samos2807/riscv-pipeline/layout/README.md

# Final layout (round 5b, 1008 MHz, zero violations)

Post-route output of `openroad/configs/riscv_final` on Nangate45:

| file | what |
|---|---|
| `6_final.gds` | GDSII stream (13 MB) |
| `6_final.def` | placed and routed DEF, units 2000 per µm, die 354980 × 354980 = 177.5 × 177.5 µm |
| `6_final.v` | post-route gate-level netlist (10,553 instances without fill, 3,413 flops, 95 CLKGATE_X1) |
| `6_final.sdc` | constraints, clock period 1.00 ns |

Not included: `6_final.odb` (19 MB) and `6_final.spef` (17 MB); both are regenerated by
the flow in about 70 minutes (see `openroad/README.md`), and every report in
`openroad/results/06_final` and `07_pd_feedback` was produced from them.
