samos2807/riscv-pipeline/openroad/images/after_reworked_1008MHz.png

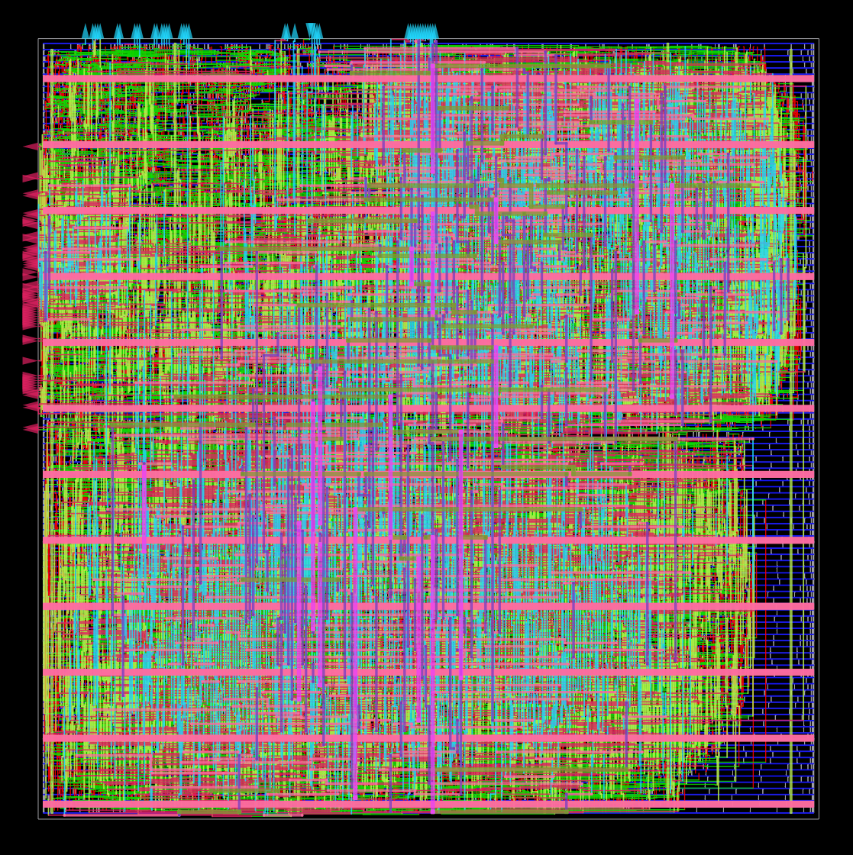
openroad/images/after_reworked_1008MHz.png
