samos2807/riscv-pipeline/openroad/images/before_published_648MHz.png

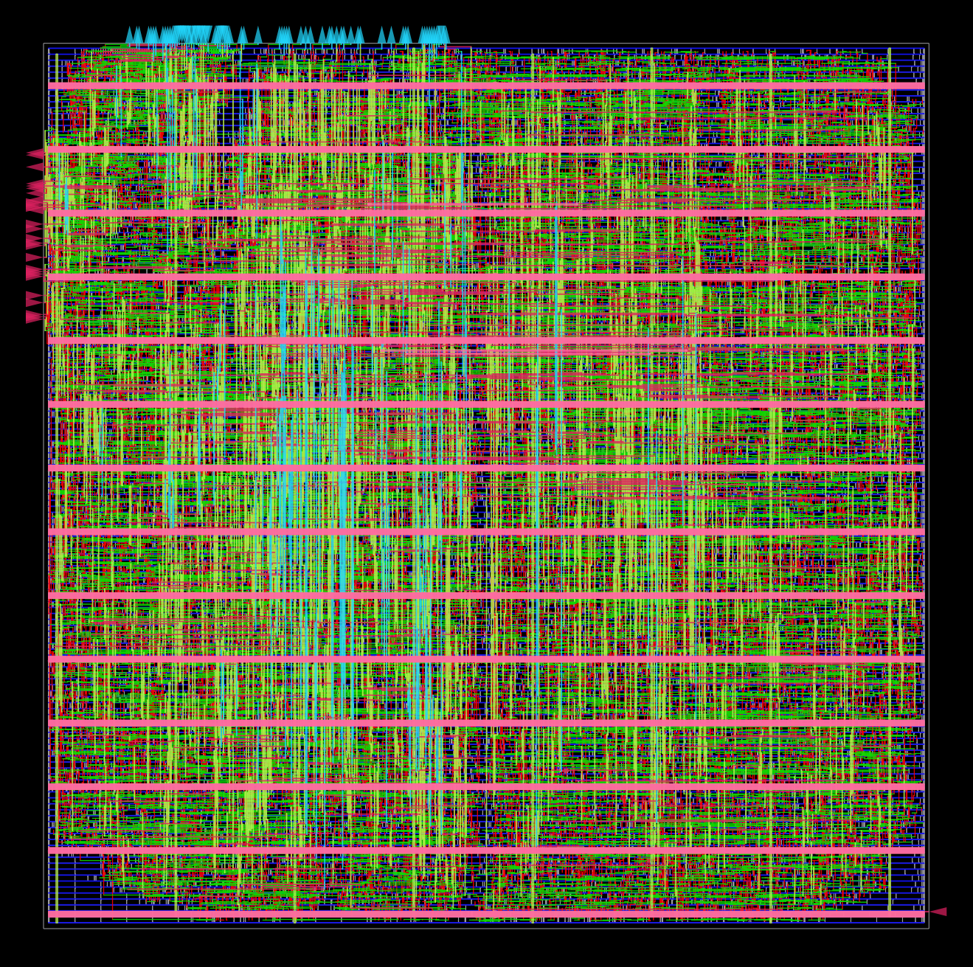
openroad/images/before_published_648MHz.png
