samos2807/riscv-pipeline/openroad/images/clock_side_by_side.png

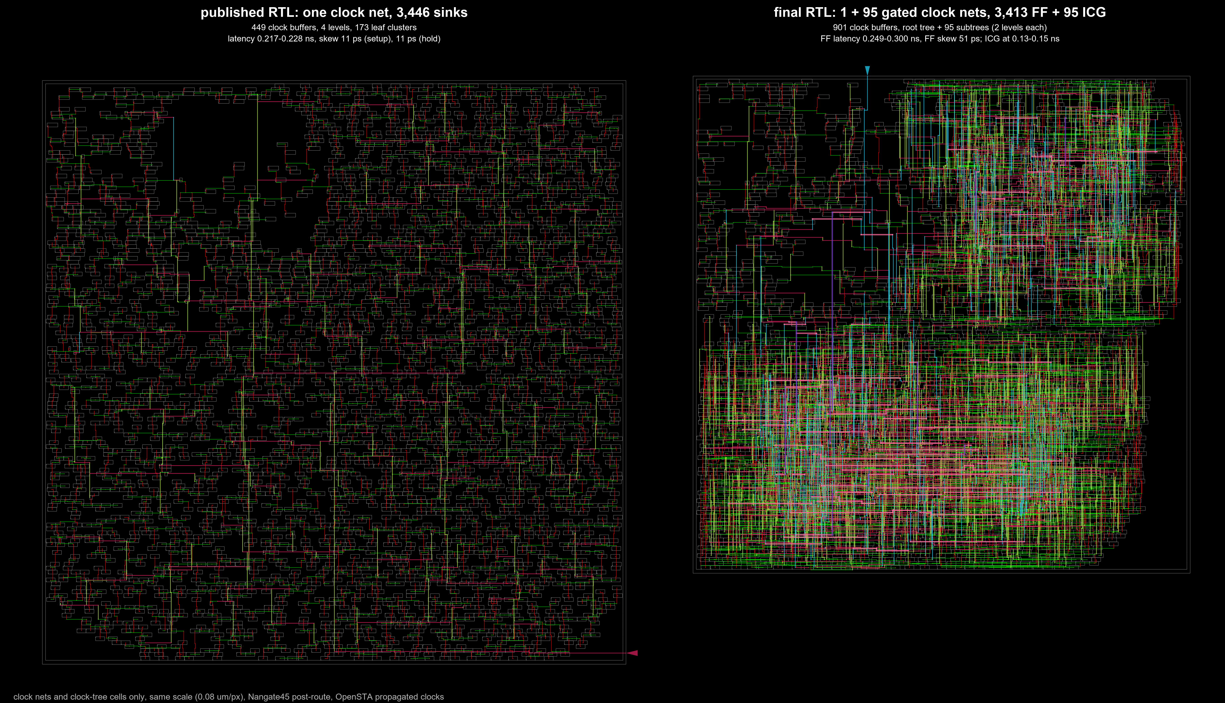
openroad/images/clock_side_by_side.png
