samos2807/riscv-pipeline/openroad/images/clock_tree.png

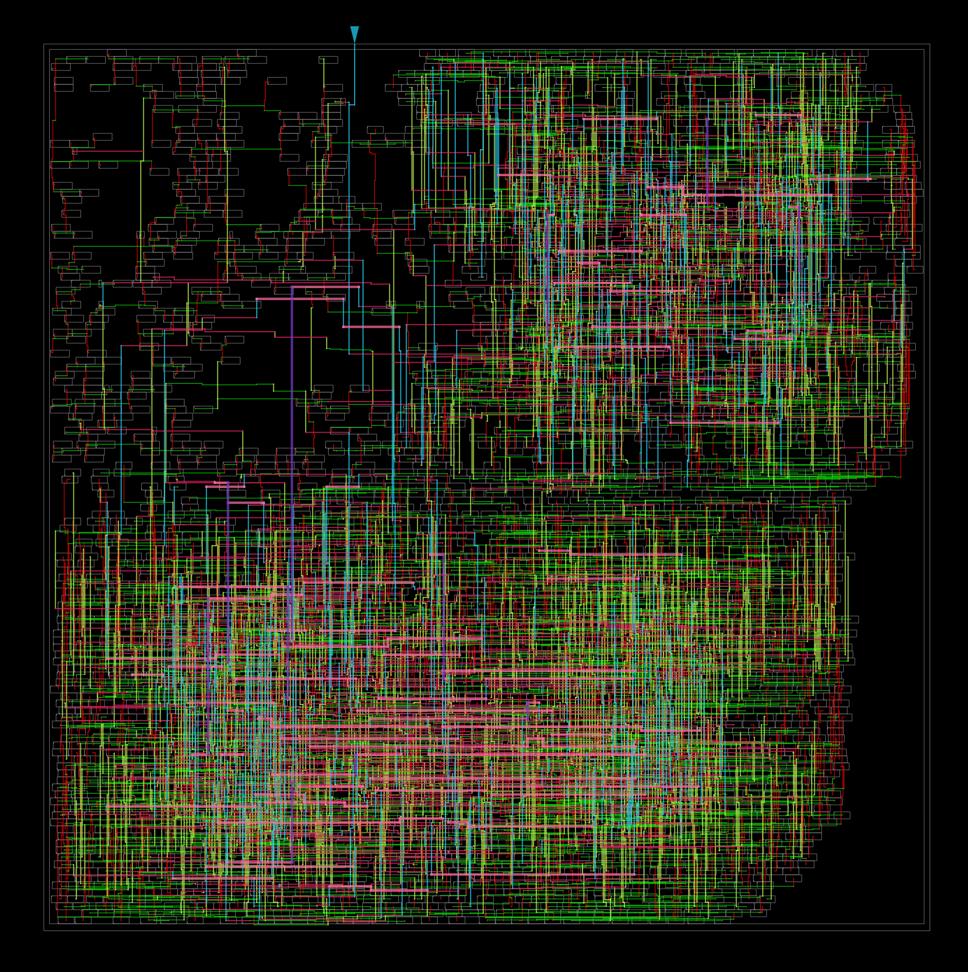
openroad/images/clock_tree.png
