samos2807/riscv-pipeline/openroad/images/critical_path.png

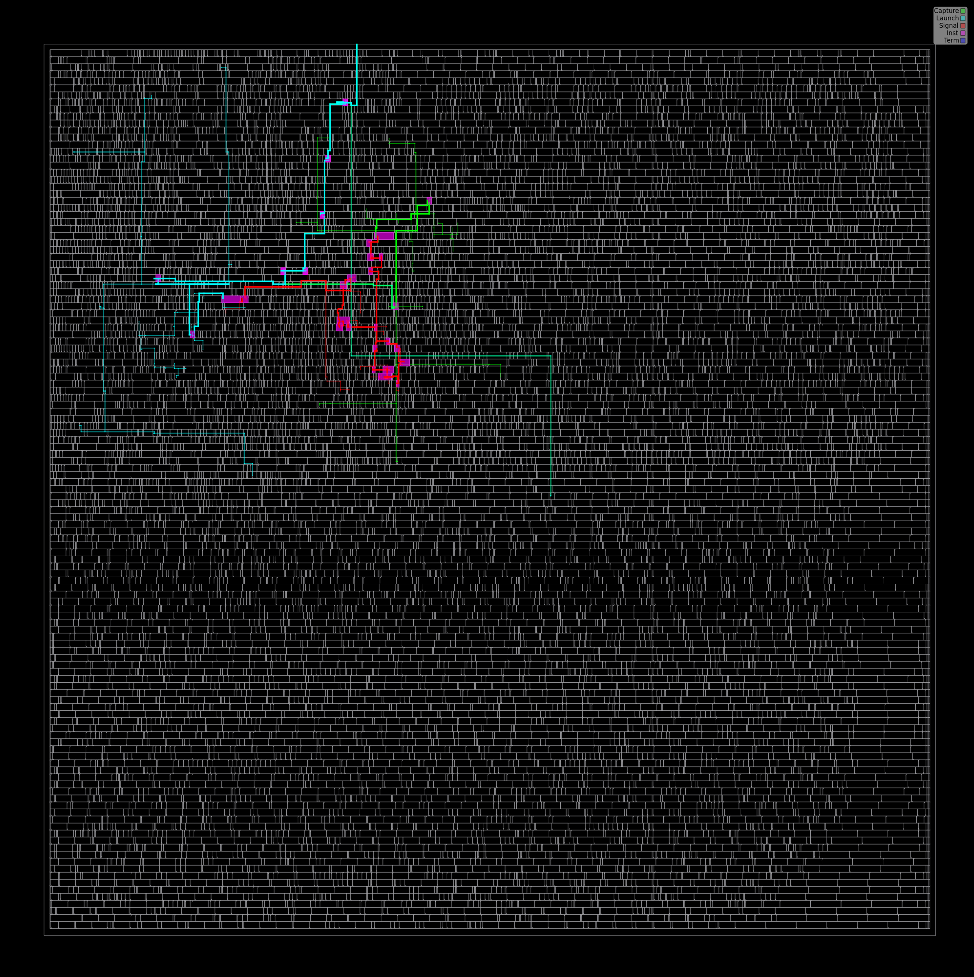
openroad/images/critical_path.png
