samos2807/riscv-pipeline/openroad/images/critical_path_zoom.png

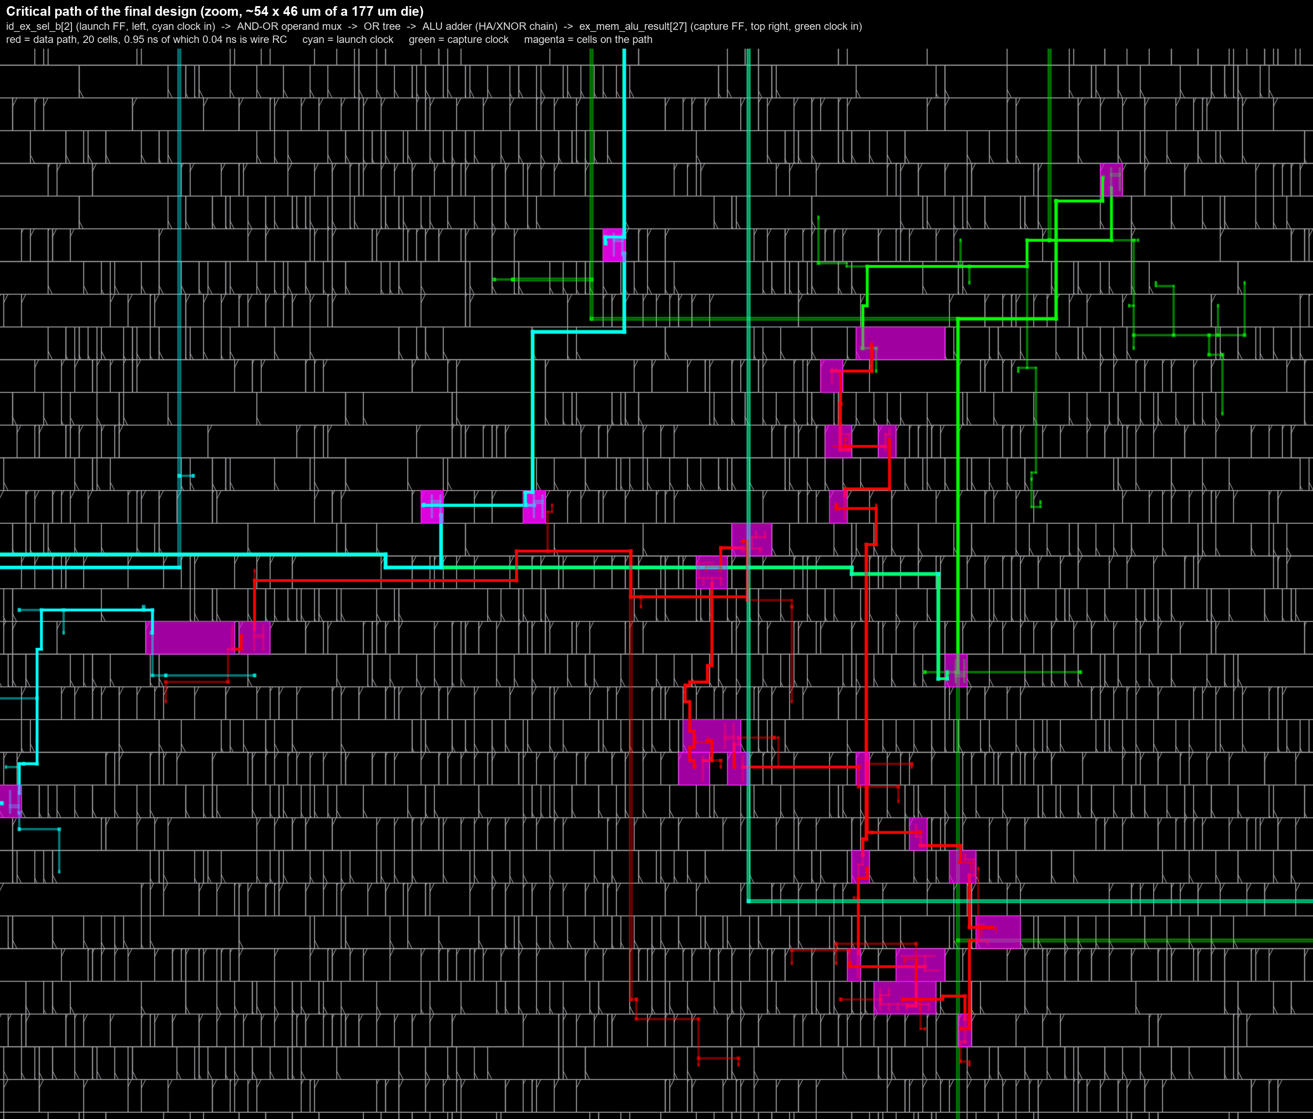
openroad/images/critical_path_zoom.png
