samos2807/riscv-pipeline/openroad/images/post_tables.png

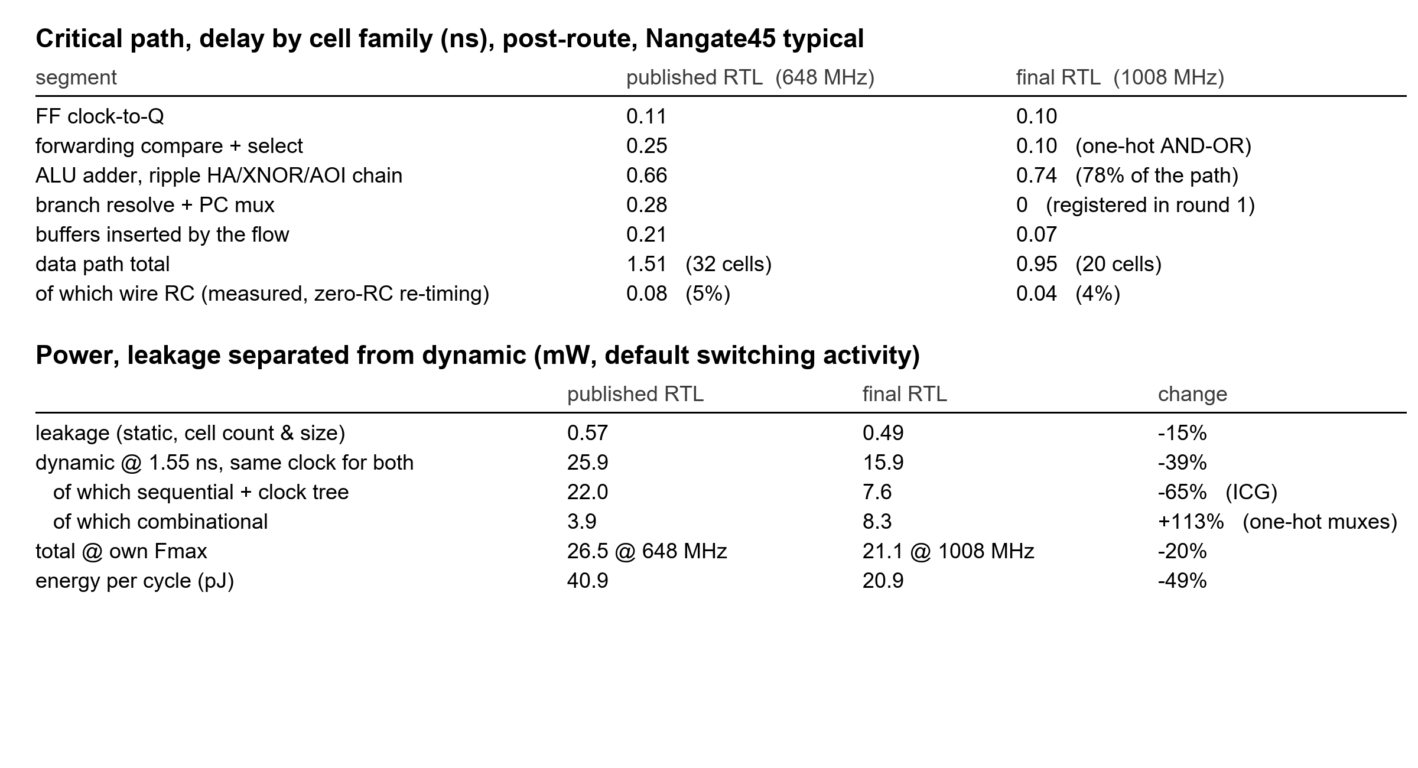
openroad/images/post_tables.png
