samos2807/riscv-pipeline/picture/drc_clean.jpg

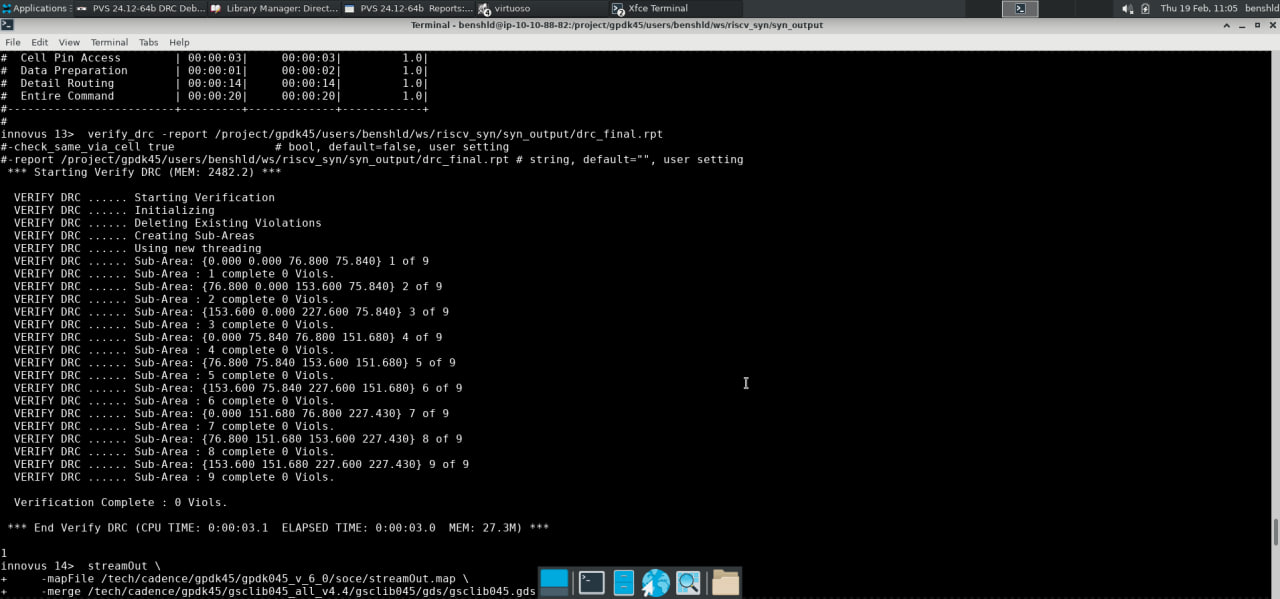
picture/drc_clean.jpg
