samos2807/riscv-pipeline/picture/layout_full.jpg

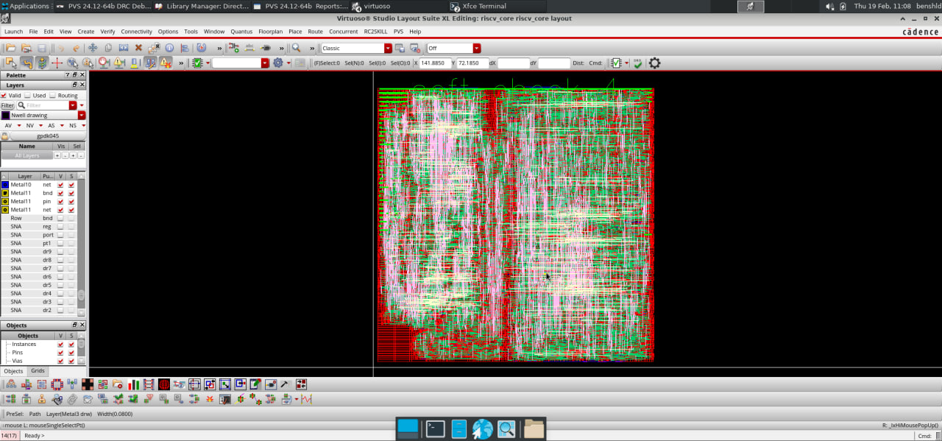
picture/layout_full.jpg
