samos2807/riscv-pipeline/picture/layout_zoom.jpg

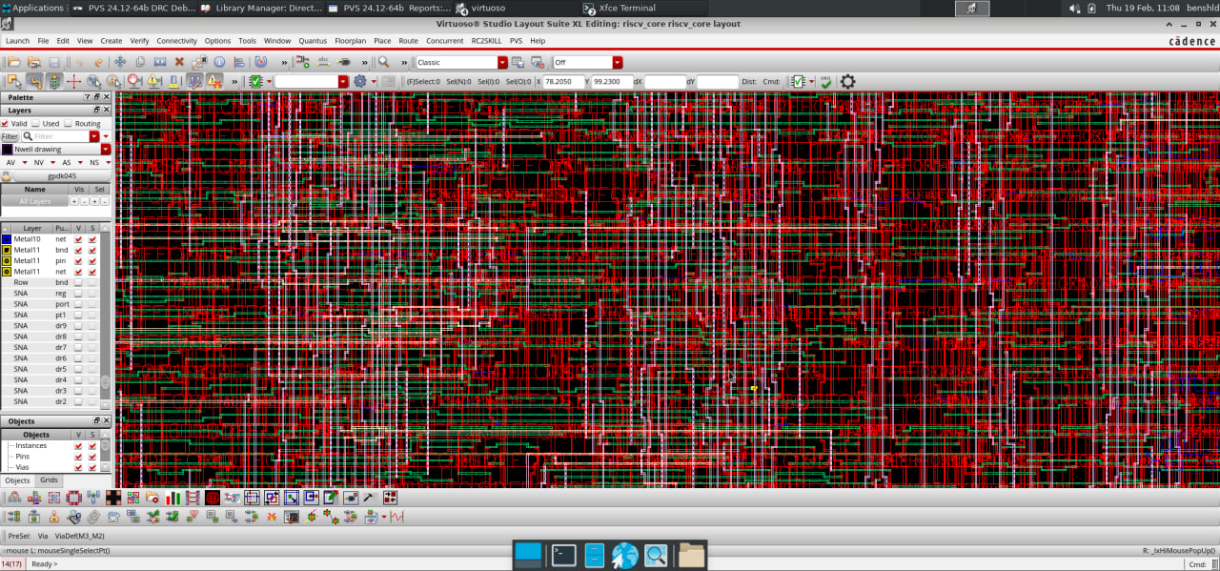
picture/layout_zoom.jpg
