samos2807/riscv-pipeline/picture/schematic.jpg

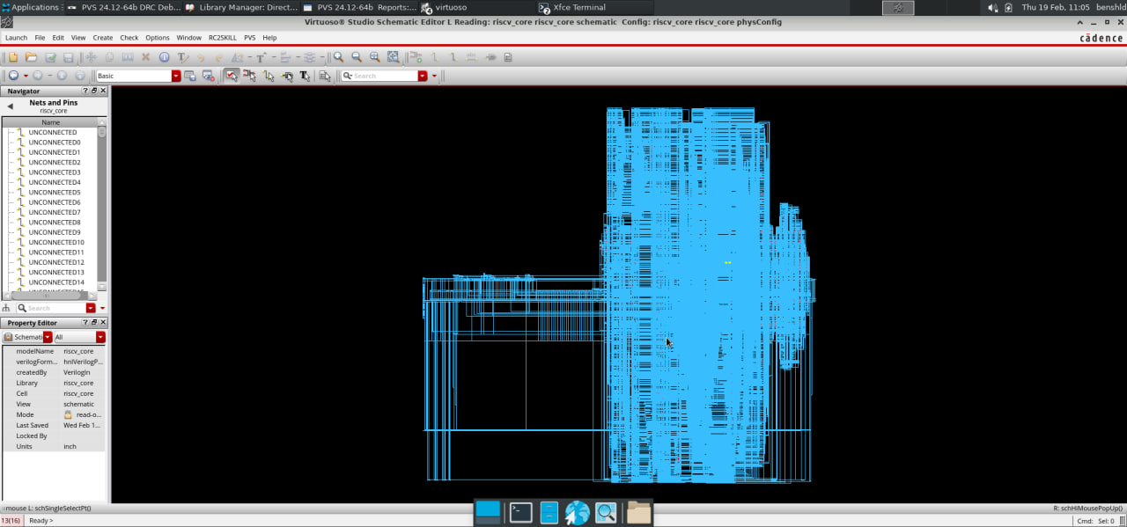
picture/schematic.jpg
