samos2807/riscv-pipeline/picture/schematic_from_vivado.jpg

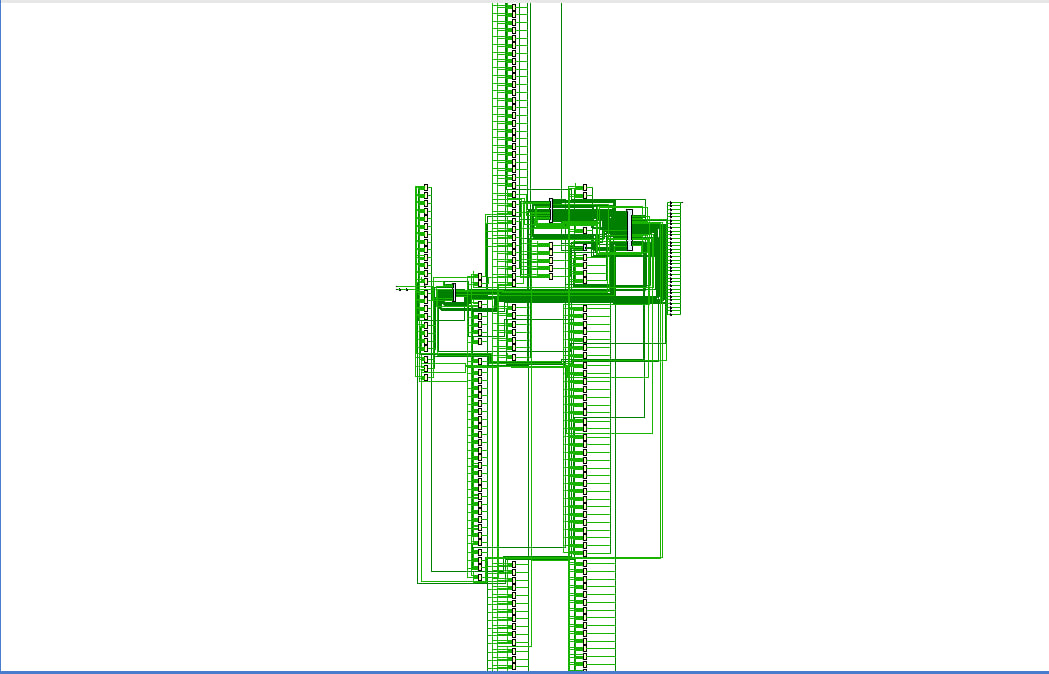
picture/schematic_from_vivado.jpg
