samos2807/riscv-pipeline/picture/schematic_zoom.jpg

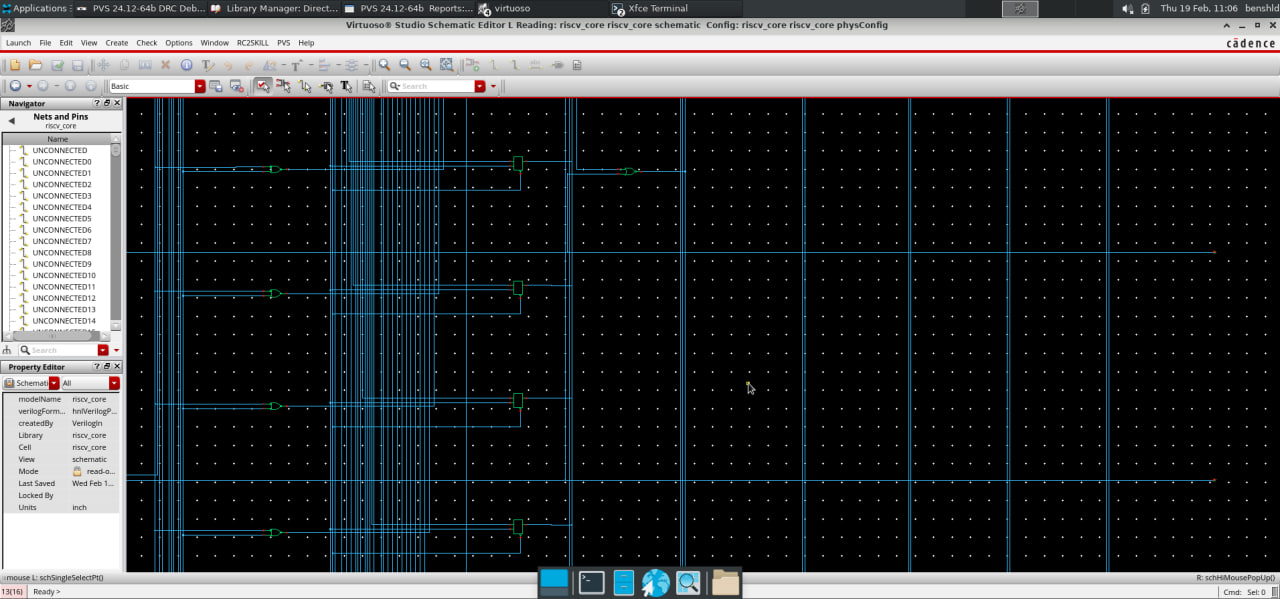
picture/schematic_zoom.jpg
