samos2807/riscv-pipeline/openroad/results/00_published/sweep_github.csv

target_period_ns | period_min_ns | fmax_mhz | wns_ns | tns_ns | setup_viol | hold_viol | design_area_um2 | seq_cells | total_power_w | status | runtime_s
1.42 | 1.53 | 655.55 | -0.11 | -9.05 | 234 | 0 | 33144 | 3446 | 2.93e-02 | TIMING_VIOL | 708
1.36 |  |  |  |  |  |  |  |  |  | FLOW_FAIL | 370
1.30 | 1.55 | 646.09 | -0.25 | -48.81 | 258 | 0 | 33345 | 3446 | 3.22e-02 | TIMING_VIOL | 845
