samos2807/riscv-pipeline/rtl_1ghz/controller.v

module controller (
    input wire [6:0]        opcode,
    output reg              reg_write,
    output reg              alu_src,
    output reg              mem_write,
    output reg              mem_to_reg,
    output reg              branch,
    output reg [1:0]        alu_op          
);
    

always @(*) begin

reg_write = 1'b0;
alu_src = 1'b0;
mem_write = 1'b0;
mem_to_reg = 1'b0;
branch = 1'b0;
alu_op = 2'b00;

    case (opcode)
        7'b0110011: begin
            reg_write = 1'b1;
            alu_src = 1'b0;
            alu_op = 2'b10;
        end

        7'b0010011: begin
            reg_write = 1'b1;
            alu_src = 1'b1;
            alu_op = 2'b00;
        end

        7'b0000011: begin
            reg_write = 1'b1;
            alu_src = 1'b1;
            mem_write = 1'b0;
            mem_to_reg =1'b1;
            alu_op = 2'b00;
        end

        7'b0100011: begin
            reg_write = 1'b0;
            alu_src = 1'b1;
            mem_write = 1'b1;
            mem_to_reg = 1'b0;
            alu_op = 2'b00;
        end

        7'b1100011: begin
            reg_write = 1'b0;
            alu_src = 1'b0;
            mem_write = 1'b0;
            mem_to_reg = 1'b0;
            branch = 1'b1;
            alu_op = 2'b01;
        end
      
        default: begin
            reg_write = 1'b0;
            alu_src = 1'b0;
            mem_write = 1'b0;
            mem_to_reg = 1'b0;
            branch = 1'b0;
            alu_op = 2'b00;
        end 
    endcase
end
    
endmodule
