samos2807/riscv-pipeline/(commit log)

2026-02-22 Add RISC-V 5-stage pipeline: RTL, testbenches, synthesis scripts, layout screenshots
    - 12 RTL modules: full 5-stage pipeline (IF/ID/EX/MEM/WB)
    - Hazard handling: forwarding unit, load-use stall, branch flush
    - Testbenches: 6 test scenarios (forwarding, stall, branch)
    - Cadence Genus synthesis script targeting GPDK045 45nm
    - STA script: WNS=+222ps, Fmax=102MHz, 0 violations
    - Virtuoso import script for gate-level schematic
    - Layout screenshots: schematic, layout, DRC clean proof
    [alu.v, alu_decoder.v, controller.v, core_tb.v, decoder.v, dmem.v, forwarding_unit.v, hazard_detection_unit.v]
2026-09-14 verif: reference-model regression for the core (hazard program + 100 random programs)
    Generic testbench that dumps the full architectural state and the retirement
    stream, a hex-loading instruction memory, and a Python reference model of the
    8 implemented instructions that generates programs and predicts the result.
    Published RTL in rtl/: hazard regression + 100 random programs, 101/101 pass.
    A mutant with EX forwarding disabled fails every program. See verif/RESULTS.md.
    [gen_prog.py, imem_hex.v, riscv_diff_tb.v]
2026-09-14 openroad: ORFS flow on Nangate45; published RTL measures 648 MHz clean
    Same 12-module RTL that closed 100 MHz on GPDK045 in Cadence, run through
    OpenROAD (synthesis to post-route STA) and pushed until it breaks:
    1.55 ns clean (648.05 MHz, cell area 32808 um2, 26.5 mW, 0 violations of any type),
    1.42 ns broken (234 setup violators), 1.36 ns fails global routing.
    Critical path: mem_wb_rd -> forwarding compare -> ALU -> branch -> pc, 32 cells,
    the path the README documented in February.
    [sweep_github.csv, sweep_github2.csv]
2026-09-14 round 1: Fix A (registered forwarding selects), Fix B (registered branch redirect) -> 742.8 MHz
    rtl_1ghz/ starts as a copy of rtl/ plus:
    - Fix A: the forwarding selects are decided in ID from rs1/rs2 vs id_ex_rd/ex_mem_rd
    and registered into ID/EX, so the 5-bit comparators leave the EX critical path.
    - Fix B: the branch redirect is registered in EX/MEM (ex_mem_redirect), cutting the
    combinational alu_zero -> PC path; a static backward-taken / forward-not-taken
    predictor in ID keeps the loop cost down. Mispredict penalty is now 3 cycles.
    Physical sweep on this RTL (util 70/76/82 x CTS cluster 20/40/60, 9 runs): 731-743 MHz,
    a 1.5 percent spread. Tightening 1.30 -> 1.10 ns left the criti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
    [sweep_pipe.csv, tighten_pipe.csv]
2026-09-14 round 2: Fix C (write-back value selected in MEM), Fix D (debug pin from a flop) -> 804.6 MHz
    Fix C: the mem_to_reg mux moves from after MEM/WB to before it, so MEM/WB holds the
    final write-back value (one 32-bit register instead of two, 33 fewer flops) and the
    EX forwarding muxes see a flop output. Fix D: alu_out_test is driven from the existing
    ex_mem_alu_result register instead of the raw ALU output, which had been the worst
    endpoint in every report. 1.25 ns clean, 804.60 MHz, 33045 um2, 32.9 mW.
    1.20 ns: one path fails (-0.03), id_ex_forward_b -> ALU subtract -> zero detect.
    [tighten_fix2.csv]
2026-09-14 round 3: Fix E (BEQ on a dedicated equality comparator) -> 925.3 MHz
    BEQ was resolved by a full 32-bit ALU subtraction followed by a 32-bit zero detect,
    about 1.0 ns of the cycle. A dedicated br_eq comparator takes the ALU out of the
    branch path. 1.10 ns clean, 925.31 MHz, 33027 um2, 36.8 mW; 1.05 ns marginal (951 MHz).
    Flow-side experiments at 1.00 ns (adder_exp.csv): disabling the platform adder map
    is worse (-0.08 vs -0.04); ABC_CLOCK_PERIOD_IN_PS=850 is bit-identical to the default.
    Remaining wall: forwarding mux levels + ALU carry chain into ex_mem_alu_result.
    [adder_exp.csv, tighten_fix3.csv, tighten_fix3b.csv]
2026-09-14 round 4: Fix F2 (one-hot AND-OR operand muxes) -> 1011.9 MHz at 1.00 ns, 1057.7 MHz at 0.95 ns
    Three MUX2 levels sat in front of the ALU adder. Fix F (a nested-ternary 4:1 mux)
    made it worse (-0.11): synthesis rebuilt the same priority chain. Fix F2 decides
    one-hot selects in ID, registers them, and builds both ALU operands as AND-OR of
    the candidates: two gate levels the tool cannot re-serialize.
    1.00 ns clean 1011.85 MHz (33131 um2, 40.4 mW); 0.95 ns clean 1057.66 MHz;
    0.90 ns breaks in the adder carry chain. Frequency work stops here.
    [fixF_exp.csv, tighten_fixF2.csv, tighten_fixF2b.csv]
2026-09-14 round 5a: Fix G (per-row clock gating of the register file and data memory) -> power -43%
    3072 of the 3446 flops are the 32x32 register file and the 64x32 data memory, every
    one clocked every cycle behind a feedback mux. icg.v wraps a CLKGATE_X1 (behavioral
    latch+AND under simulation); one gater per row: 31 for x1..x31, 64 for the data
    memory, 95 in total. Combinational cells 9309 -> 5002.
    At 1.00 ns: 23.2 mW (was 40.4), 24994 um2 (was 33131), one path -0.02 through the
    64:1 data-memory read mux. 1.05 ns clean: 969.28 MHz, 22.1 mW. Utilization 82 fails
    global routing (95 non-default-rule clock nets).
    [gated_util.csv, tighten_fixG.csv, tighten_fixG2.csv, tighten_fixG3.csv]
2026-09-15 round 5b: Fix H (one-hot data-memory read) + pre-route repair hook -> 1 GHz, zero violations of any type
    Fix H: the 64:1 data-memory read mux becomes a one-hot AND-OR, closing the last
    -0.02 ns path of the gated design. 1.00 ns: 1007.55 MHz, 24770 um2, 20.9 mW, but the
    full post-route check_types report showed 7 max-capacitance violators: NOR3_X1 gates
    driving clock-gater enable pins at 17-23 fF against a 16 fF limit.
    Root cause, measured on the global-route database (measure_enable_caps.tcl): the
    estimate was already 22.9 fF, so not an estimation error. ORFS runs repair_design
    then repair_timing at that stage and never re-checks capacitance; the enable paths
    are clock-gating-check paths wi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
    [tighten_fixH.csv]
2026-09-17 fix die size: DEF units are 2000/um, so the dies are 208.4 and 177.5 um, not 416.7 and 355; add utilization and instance counts
    The area ratio (-27.4% die, -24.0% cells) and the same-scale image are unchanged; only the absolute die labels and the um/px note were wrong by 2x. Post-route utilization 77% and 81% now reconciles with the cell areas.
2026-10-04 power: leakage vs dynamic split, before and after, at own clock and at equal clock
    openroad/scripts/power_split.tcl re-reports power on the routed databases with their own SPEF.
    Leakage 0.572 -> 0.488 mW (-15%, 2% of total at Nangate45 typical); dynamic at the same
    1.55 ns clock 25.9 -> 15.9 mW (-39%), all in the sequential and clock groups (ICG);
    combinational dynamic rose 4.2 -> 8.6 mW under default activity (one-hot AND-OR paths).
    Instance counts in the README corrected to the ODB values (13,890 / 10,553 without fill).
    Cadence power: no report survives and the license expired; documented as not producible.
2026-10-04 PD feedback follow-up: clock tree skew/latency, critical-path breakdown and wire share, NDR routing experiment, clock mesh assessment
    Clock: report_clock_skew/latency and per-sink latency dump for both designs; published tree 11 ps skew, gated tree 51 ps flop-to-flop with ICGs 0.11 ns earlier by construction; 449 -> 901 clock buffers.
    Critical path: per-cell-family breakdown (adder 0.74 of 0.95 ns), zoomed captioned picture, wire share measured by zero-RC re-timing: 41 ps (4%).
    Routing skeleton experiment: NDR on the 19 critical nets before global route; clock NDR crashed GRT (GRT-0183), width-only NDR routed clean: original path -10 ps, Fmax 1008.4 -> 1012.9 MHz, worst path moves to the nei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
2026-10-04 images: path breakdown and power split as one table image
2026-10-05 results: add the flow logs the February .gitignore (*.log) had excluded
    6_report logs per round, the power split logs, the final route log and the failed-attempt log of the NDR experiment.
2026-10-05 gitignore: keep flow logs, verification logs and the final GDS tracked
